HerMak56/DetaliMashine/Курсавая дед маш.docx

Московский государственный технический университет имени Н. Э. Баумана

Факультет «Робототехника и комплексная автоматизация»

Кафедра «Основы конструирования машин»

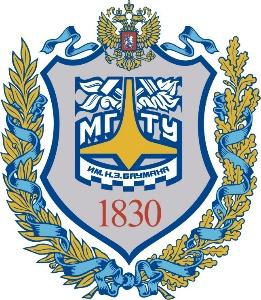
[picture p1: figure]
Gerb-BMSTU_01

МАЛ.2А213

Расчетно-пояснительная записка

к курсовому проекту

на тему:

«Привод цепного транспортёра МАЛ.2А213»

Студент РК9-63Б Девчич Г.А.

Руководитель проекта: Любченко М.А.

Дата___________________

Москва, 2023г.

Утверждаю __________

ФИО Любченко М.А.

Оглавление

1) Техническое задание
2) Обоснование выбора кинематической схемы
3) Расчет кинематических параметров
4) Результаты расчета ЭВМ
5) Расчет подшипников тихоходного вала
6) Расчет тихоходного вала на прочность и выносливость
7) Расчет соединений тихоходного вала
8) Выбор муфты
9) Список литературы

# ТЗ Обоснование выбора кинематической схемы

Целевой показатель – максимальный КПД. Для минимального передаточного отношения возьмём электродвигатель с частотой 750 об/мин. Для минимальных потерь на КПД возьмем цилиндрический редуктор по развернутой схеме.

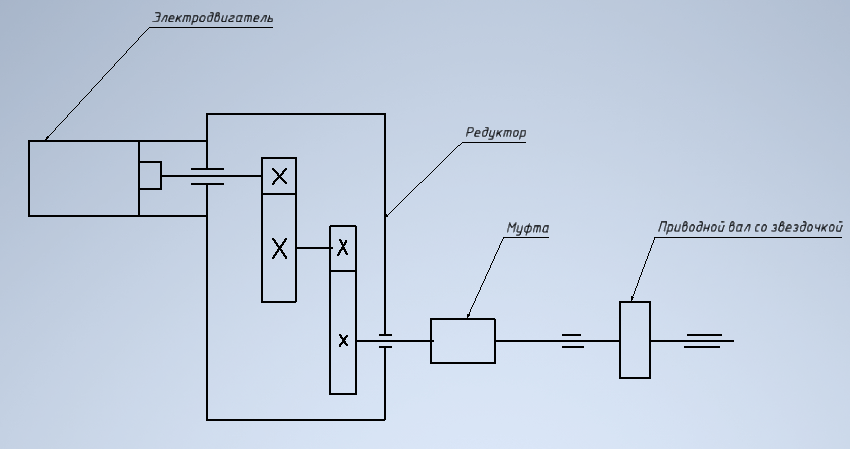
[picture p2: figure]

# Кинематический расчет привода

Для проектирования цепного транспортера, прежде всего, необходимо выбрать электродвигатель. Для этого определим мощность, потребляемую движущим устройством (цепным транспортёром), оценим КПД привода, подсчитаем вращающие моменты на валах привода. Таким образом, определим исходные данные для расчета передач.

Потребляемая мощность привода:

P_к =(F_t *v)/1000=(4.2*10^3 *0.315)/1000=1.323 кВт

Частота вращения приводного вала:

D=P/(sin((180°)/Z))=80/(sin((180°)/6))=160 мм

n_в =(6*10^4 *υ)/(π∙D)=(6*10^4 *0.315)/(3,14*160)=37.6 мин^(-1)

Тогда частота вращения тихоходного вала редуктора:

n_(тих) =n_в =37.6 (об)/(мин)

Общий коэффициент полезного действия:

η_(общ) =η_(оп) *η_(ред) *η_м =0.99*0.97^2 *0.98=0.91

Требуемая мощность электродвигателя:

P_(эл) =(P_к)/(η_(общ))=1.323/(0,91)=1.45 кВт

По таблице выбираем подходящий электродвигатель 100L7/702.

Определив двигатель и частоту вращения его шпинделя, уточним передаточное отношение редуктора.

U_(ред) =(n_б)/(n_(тих))= (n_(дв))/(n_в)= 702/37.6=18.7

Далее, определим момент на тихоходном валу.

Т_т =(P_т *9550)/(n_(тих))

Для вычисления момента, необходима мощность на тихоходном валу:

P_т =P_к =1.323 кВт

Таким образом момент на тихоходном валу:

Т_т =(P_т *9550)/(n_(тих))= (1.323*9550)/37.6=336.1 Н*м

# Компоновочная схема

Крутящий момент в поперечных сечениях валов:

1) Быстроходного: Tб= 18.1 H•м

2) Промежуточного: T_(пр) =164.1 H•м

3) Тихоходного: Tт= 336.1 H•м

Предварительные значения диаметров различных участков стальных валов редуктора округляются в ближайшую сторону до стандартных, диаметры концов валов согласуются с ГОСТ 12080-66 (цилиндрические концевые участки валов), высота заплечика, координата и размер фаски подшипника принимается согласно нормативам.

## Диаметры валов

Для быстроходного вала:

d≥7.5*³√(Т_б)=7.5*³√18.1=19.7 мм

Округляем согласно ГОСТ 6636-69 d=20 мм

d_П ≥d+2*t_(цил) =20+2*3=26 мм

Так как данный диаметр будет диаметром для подшипника кратен 5 =>

d_П =30 мм

d_(БП) ≥d_П +3*r=30+3*1.5=34.5 мм

Округлим до 35 мм

Для промежуточного вала:

d_К ≥6.5*³√(Т_(ПР))=6.5*³√82.01=28.24 мм

Округляем согласно ГОСТ 6636-69 d_К =30 мм

d_(БК) ≥d_К +3*f=30+3*1=33 мм

d_П =d_К -3*r=30-3*2=24 мм ≈25 мм

d_(БП) ≥d_П +3*r=25+3*2=31 мм

Для тихоходного вала:

d≥5.5*³√(Т_Т)=5.5*³√336.1=38.4 мм

Округляем согласно ГОСТ 6636-69 d=40 мм

d_П ≥d+2*t_(цил) =40+2*3.5=47 мм

Так как данный диаметр будет диаметром для подшипника кратен 5 =>

d_П =50

d_(БП) ≥d_П +3*r=50+3*2.5=57.5 мм

## Эскизная компоновка редуктора

Чтобы поверхности вращающихся колес не задевали за внутренние поверхности стенок корпуса, между ними оставляем зазор:

a≈³√L+3=10 мм

Расстояние между дном корпуса и поверхность колес:

b_0 ≥3∙a=3∙10=30мм

Расстояние между торцевыми поверхностями колес:

c=(0,3…0,5)∙a=0,5∙10=5мм

Толщина стенки редуктора:

δ=1,3⁴√(T_T)=1,3⁴√336.1=5.56≅6мм

Диаметр винтов крепления крышки:

d_(кр) =1,3³√(T_T)=1,3³√336.1=9.036≅М10

Диаметр винтов крепления корпуса к раме:

d_к =1,5∙d_(кр) =1,5∙10=15≅М16

# Результаты расчета ЭВМ

МЕХАНИЗМЫ ПЕРЕДАТОЧНЫЕ РАСЧЕТ ПРОЕКТНЫЙ ПРОГРАММА N 44

Зубчатые цилиндрические двухступенчатые

По развернутой схеме косозубые

══════════════════════════ ИСХОДНЫЕ ДАННЫЕ ══════════════════════════════════

Вращающий момент на тихоходном валу, Н.м . . 336.1

Частота вращения тихоходного вала, об/мин . . 37.6

Ресурс, час . . . . . . . . . . . . . . 10000.

Режим нагружения . . . . . . . . . . . . . . 1.

Передаточное отношение редуктора . . . . . . 18.70

Коэффициент ширины венца . . . . . . . . . . .315

Степень точности . . . . . . . . . . . . . . 8.

Коэффициент запаса по изгибной прочности . . . 2.20

Твердость поверхности зубьев Шестерни, HRCэ . .0 ВАРЬИРУЕТСЯ

Колеса, HRCэ . .0 ВАРЬИРУЕТСЯ

Минимальное допустимое число зубьев Шестерни . 12.

Отношение передаточных чисел ступеней . . . . .00 ВАРЬИРУЕТСЯ

Угол наклона зубьев, град . . . . . . . . . . .000

ПРОГРАММА N 44 ИМЯ ФАЙЛА ДАННЫХ:32111

МЕХАНИЗМЫ ПЕРЕДАТОЧНЫЕ РАСЧЕТ ПРОЕКТНЫЙ

Зубчатые цилиндрические двухступенчатые

По развернутой схеме косозубые

ПАРАМЕТРЫ ДЛЯ ВЫБОРА ВАРИАНТА

══╤═══════════╤═════╤═════╤═══════╤════════╤═══════════════════╤═══════════════

В│ Твердости,│Коэф.│Отнош│Суммарн│Диаметр │ Диаметры вершин │ Массы

а│ HRCэ │ширин│перед│межосев│впадин │ Колес, мм │ кг

р├─────┬─────┤венца│чисел│расст.,│Б-Шестер├─────────┬─────────┼────────┬──────

│Шест.│Колес│ │ступе│ мм │ни, мм │Т-ступень│Б-ступень│механ. │колес

──┴─────┴─────┴─────┴─────┴───────┴────────┴─────────┴─────────┴────────┴──────

1 28.5 24.8 .315 .70 240.00 35.91 255.35 143.34 49. 12.8

2 28.5 24.8 .315 1.00 245.00 31.21 247.24 158.04 49. 13.0

3 28.5 24.8 .315 1.30 255.00 31.25 241.16 178.00 51. 13.7

4 49.0 28.5 .315 .70 200.00 28.39 213.35 120.86 38. 7.5

5 49.0 28.5 .315 1.00 200.00 25.20 199.04 134.05 37. 7.0

6 49.0 28.5 .315 1.30 210.00 26.76 193.15 152.49 38. 7.5

7 59.0 59.0 .315 .70 168.00 22.20 174.82 102.80 31. 4.4

8 59.0 59.0 .315 1.00 163.00 22.20 168.72 102.80 29. 4.0

9 Bариант отброшен по конструктивным ограничениям:

мало расстояние между колесом быстроходной ступени и тихоходным валом

**

МЕХАНИЗМЫ ПЕРЕДАТОЧНЫЕ РАСЧЕТ ПРОЕКТНЫЙ

Зубчатые цилиндрические двухступенчатые

По развернутой схеме косозубые Вариант 8

═══════════════════════════ РЕЗУЛЬТАТЫ РАСЧЕТА ══════════════════════════════

Характеристика механизма

Передаточное отношение механизма . . . . . . . . . . . . . 18.545

Вращающий момент на Быстроходном валу, Н.м . . . . . . . . 18.7

Тихоходном валу, Н.м . . . . . . . . 336.1

Частота вращения Быстроходного вала, об/мин . . . . . . . . 697.3

Тихоходного вала, об/мин . . . . . . . . 37.6

Масса Механизма, кг . . . . . . . . . . . . . . . . . . . 29.3

Колес, кг . . . . . . . . . . . . . . . . . . . 4.03

Степень точности . . . . . . . . . . . . . . . . . . . 8.

───────────────────────────────────────────────┬───────────────┬──────────────

Ступень │ Тихоходная │ Быстроходная

───────────────────────────────────────────────┴───────────────┴──────────────

Передаточное число . . . . . . . . . . 4.636 4.000

Коэффициент ширины венца . . . . . . . . . . .315 .315

Межосевое расстояние, мм . . . . . . . . . . 100.000 63.000

Угол зацепления, град . . . . . . . . . . 21.374 20.915

Угол наклона зубьев, град . . . . . . . . . . 21.565 17.753

Модуль зацепления (нормальный), мм . . . . . 3.000 2.000

Силы в зацеплении, Н:

Окружная (суммарная для шеврона) . . . . 4085.9 1467.7

Радиальная (суммарная для шеврона) . . . . 1599.1 560.9

Осевая . . . . 1614.9 469.9

Вращающий момент на Шестерне, Н.м . . . . 74.0 18.7

Контактные напряжения, МПа:

при номинальной нагрузке:

расчетные . . . . . . . . . . . . . 976.9 899.2

допускаемые . . . . . . . . . . . . . 1278.6 1074.3

при максимальной нагрузке:

расчетные . . . . . . . . . . . . . 1449.0 1333.8

допускаемые . . . . . . . . . . . . . 2596.0 2596.0

──────────────────────────────────────┬───────────────────┬──────────────────

Ступень │ Тихоходная │ Быстроходная

──────────────────────────────────────┼─────────┬─────────┼─────────┬────────

Параметры зубчатого Колеса │ Шестерня│ Колесо │ Шестерня│ Колесо

──────────────────────────────────────┴─────────┴─────────┴─────────┴────────

Число зубьев . . . . . . . . 11. 51. 12. 48.

Коэффициент смещения исходного контура .300 -.300 .500 -.500

Диаметры, мм:

Делительный . . . . . . . . 35.484 164.516 25.200 100.800

Начальный . . . . . . . . 35.484 164.516 25.200 100.800

Вершин . . . . . . . . 43.284 168.716 31.200 102.800

Впадин . . . . . . . . 29.784 155.216 22.200 93.800

Ширина зубчатого венца, мм . . . . 35.0 32.0 22.0 20.0

Твердость поверхности зубьев, HRCэ . . 59.0 59.0 59.0 59.0

Напряжения изгиба, МПа:

при номинальной нагрузке:

расчетные . . . . . . . . 180.1 192.0 148.7 184.2

допускаемые . . . . . . . . 323.1 318.2 333.4 330.3

при максимальной нагрузке:

расчетные . . . . . . . . 396.3 422.4 327.2 405.3

допускаемые . . . . . . . . 1194.6 1176.5 1196.4 1185.6

ПРОГРАММА N 44 ИМЯ ФАЙЛА ДАННЫХ:32111

**

# Расчет соединений

## Расчет шпонки быстроходного вала

Рабочая длина шпонки lраб назначается таким образом, чтобы нагрузочная способность соединения ограничивалась напряжениями смятия σсм на боковых гранях шпонки. В расчете условно полагаем распределение σсм равномерным.

σ_(см) =(2∙T∙10^3)/(d∙(h-t)∙l_(раб))≤[σ_(см) ]

[σ_(см) ] – допускаемое напряжение для материала шпонки;

T – момент на валу.

d – диаметр вала.

h – высота шпонки, t – глубина врезания шпонки.

b – ширина шпонки.

Тогда полная длина шпонки:

L=l_(раб) +b

Шпонки изготовляются из чисто-тянутой стали 45 σ_Т =360МПа. Поэтому допускаемое напряжение:

[σ_(см) ]=(σ_Т)/S=(360МПа)/2=180Мпа

Найдем потребную рабочую длину шпонки:

l_(раб) =(2∙T∙10^3)/(d∙(h-t)∙[σ_(см) ])

Для быстроходного вала:

d=28 мм.

TБ=18.1 Н ∙ м.

Параметры выбранной шпонки по ГОСТ 23360-78:

b= 8 мм.

h=7 мм.

t1=4 мм.

l_(раб) =(2∙18.1∙10^3)/(28∙(7-4)∙180)=2.39мм

Тогда полная длина шпонки:

L=2.5+8=10.5мм

Значит изначальной длинны шпонки в 56 мм будет достаточно

## Расчет шпонки тихоходного вала

σ_(см) =(2∙T∙10^3)/(d∙(h-t)∙l_(раб))≤[σ_(см) ]

[σ_(см) ] – допускаемое напряжение для материала шпонки;

T – момент на валу.

d – диаметр вала.

h – высота шпонки, t – глубина врезания шпонки.

b – ширина шпонки.

Тогда полная длина шпонки:

L=l_(раб) +b

Шпонки изготовляются из чисто-тянутой стали 45 σ_Т =360МПа. Поэтому допускаемое напряжение:

[σ_(см) ]=(σ_Т)/S=(360МПа)/2=180Мпа

Найдем потребную рабочую длину шпонки:

l_(раб) =(2∙T∙10^3)/(d∙(h-t)∙[σ_(см) ])

Для быстроходного вала:

d=50 мм.

TБ=336.1 Н ∙ м.

Параметры выбранной шпонки по ГОСТ 23360-78:

b=16 мм.

h=10 мм.

t1=6мм.

l_(раб) =(2∙336.1∙10^3)/(50∙(10-6)∙180)=18.6мм

Тогда полная длина шпонки:

L=18.6+16=34.6мм

Минимальная длина, заданная ГОСТом L=45 мм

## Расчет соединения с натягом для тихоходного вала

СОЕДИНЕНИЯ РАСЧЕТ ПРОЕКТНЫЙ

с Натягом

═══════════════════════════ ИСХОДНЫЕ ДАННЫЕ ═════════════════════════════

Способ сборки . . . . . . ЗАПРЕССОВКА

Осевая сила, Н . . . . . . . .0

Вращающий момент, Н.м . . . . . . . 345.0

Коэффициент запаса сцепления . . . . 3.5

Номинальный диаметр соединения, мм . . 65.0

Длина контакта, мм . . . . . . . 70.0

Диаметр отверстия в вале, мм . . . . . .0

Наружный диаметр втулки, мм . . . . . 181.5

Параметры: Вала Втулки

Параметр шероховатости Ra, мкм . . . . 3.3 6.3

Рабочая температура, °C . . . . . . 40.0 40.0

Модуль упругости, МПа . . . . . . 190000. 190000.

Коэффициент Пуассона . . . . . . .24 .33

Kоэффициент линейного расширения, 1/ °C .000012 .000012

Предел текучести, МПа . . . . . . 330. 330.

Коэффициент трения при расчете . . . . .08

Коэффициент трения при запрессовке . . . .20

СОЕДИНЕНИЯ РАСЧЕТ ПРОЕКТНЫЙ

с Натягом

Сборка запрессовкой

ПАРАМЕТРЫ ДЛЯ ВЫБОРА ВАРИАНТА

══╤═════════╤════════════════════════╤═════════════════════════╤═════════

│ │ Отклонения, мкм │ Вероятностный натяг, мкм│ Сила

В│ Посадка ├─────────┬──────┬───────┼────────────┬────────────┤ запрес-

а│ │ Верхнее │Нижнее│Верхнее│ мини- │ макси- │совки, кН

р│ │отверстия│ вала │ вала │ мальный │ мальный │

──┴─────────┴─────────┴──────┴───────┴────────────┴────────────┴─────────

1 H7/v7 30. 102. 132. 81. 123. 247.1

2 H8/x8 46. 122. 168. 89. 155. 356.8

3 H7/x7 30. 122. 152. 101. 143. 317.1

4 H7/y7 30. 144. 174. 123. 165. 394.2

**

# Расчет подшипников на долговечность

## Расчёт подшипников тихоходного вала

Исходные данные:

Частота вращения вала n=37.6 об/мин

Вероятность безотказной работы 90%

Требуемый ресурс L10ah=10000 часов

Радиальная сила в зацеплении тихоходной ступени Fr1= 1599.1Н

Окружная сила в зацеплении тихоходной ступени Ft1= 4085.9Н

Осевая сила в зацеплении тихоходного вала F_a =1614.9 Н

Режим нагружения I

Консольная нагрузка Fк= 250*√(T_T) =4583.2 Н

l=112.25 мм

l1=36 мм

l2=67.75 мм

d = 164.5 мм

Расчётная схема:

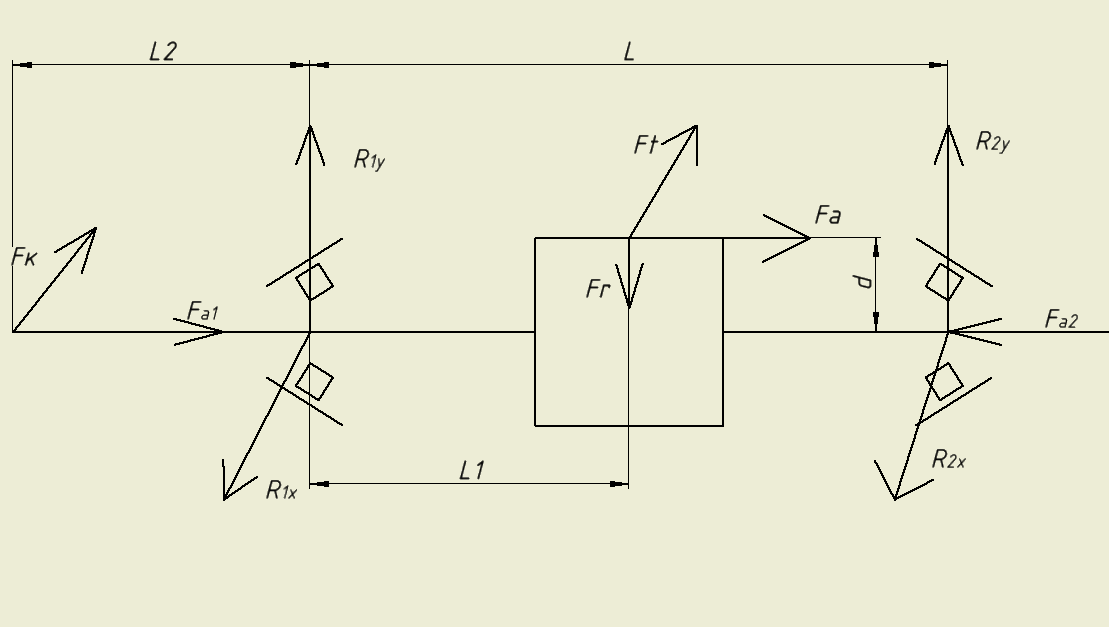
[picture p3: figure]

Определение радиальных реакций опор от сил в зацеплении.

Считая, что в худшем случаем консольная сила совпадет с суммарными реакциями опор:

В плоскости YOZ

∑ M_1 =F_r *l1+F_a *d/2-R_(2y) *l=0;

R_(2y) =1696.15Н

По сумме силы вдоль оси Oy найдем недостающую реакцию.

∑ F_y =R_(1y) -F_r +R_(2y) =0

R_(1y) =-97.05Н

В плоскости XOZ

∑ M_1 =-F_t *l1+R_(2x) *l=0

R_(2x) =1310.4Н

По сумме силы вдоль оси Oy найдем недостающую реакцию.

∑ F_x =R_(1x) +R_(2x) -F_t =0

R_(1x) =2775.5Н

R_1 =√(R_(1x) ^2 +R_(1y) ^2)=2777.2Н

R_2 =√(R_(2x) ^2 +R_(2y) ^2)=2143.13Н

∑ M_1 =F_к ∙l_2 -R_(2к) ∙l=0;

R_(2к) =2766.2 Н

∑ M_2 = F_к ∙(l_2 +l)-R_(1к) l=0;

R_(1к) =7757.7 Н

Для 1 режима нагружения, коэффициент эквивалентности 0,8. Эквивалентные нагрузки: F_(r1max) =R_1 +R_(1к) =10534.9 Н , F_(r2max) =R_2 +R_(2к) =5532. Н , F_(r2) =K_E ∙F_(r2max) =8427.2 Н F_(r1) =K_E ∙F_(r1max) =4425.6 Н

Поскольку в данной системе присутствует осевая сила, и подшипники являются регулируемыми, то запишем уравнение совместности:

{, F_(a1) +F_a -F_(a2) =0, F_(a1) ≥0.83e*R_1 =1469.2 H, F_(a2) ≥0.83e*R_2 =2797.8 H

Пусть F_(a1) =1469.2 , подствами в систему уравнений выше, получим что F_(a2) =3084.1>656,65

Таким образом, мы подобрали осевые регулировки у подшипников.

(F_(a1))/(R_1)=0.34<e

что не превышает полученного значения параметра осевого нагружения, а значит, и . Следовательно, эквивалентная динамическая нагрузка в опоре 1 составляет:

P_(r1) =(1*4426.6+0)*1,5=6638.4 H

(F_(a2))/(R_2)=1,24>e

P_(r2) =(1,4*5532+0.8*2537)*1,5=14661.6 H

Так как подшипник у опоры 2 является наиболее нагруженным, ведем расчет по нему.

P_(r2) =P_r = 14661.6 H

Для проведения дальнейших расчетов проверим соблюдение условия . Эта проверка выполняется без учета коэффициента типового режима нагружения:

P_(re) =P_r *k_e =0.8*14661.6=11729.2 H

Здесь – коэффициент, учитывающий номер типового режима нагружения, значение которого выбрано в соответствии с Таблицей П3.8 Приложения П3 для типового режима нагружения 1.

Определим системный коэффициент модификации ресурса по формуле:

Коэффициент относительной вязкости смазочного материала зависит от вязкости смазочного материала и вычисляется по формуле:

где – действительная кинематическая вязкость смазочного материала с учетом температуры, для масла И-Г-А-46 равная [6]:

Номинальная кинематическая вязкость масла для подшипника 7210А равного:

Тогда номинальная кинематическая вязкость составляет:

Следовательно:

Коэффициент
Значение | 2,5859 | 1,3993 | 0,054381 | 0,4 | 1,0 | 1 | 9,185

Тогда системный коэффициент модификации ресурса будет равен:

Следовательно, расчетный ресурс подшипника 7206А в часах для наиболее нагруженной опоры равен:

Отношение эквивалентной динамической нагрузки к динамической грузоподъемности:

(P_r)/(C_r)=8876.52/70400=0,107 , следовательно, принимаем поле допуска вала k6.

Для внешнего кольца:

(P_r)/(C_r)=8876.52/70400=0,107 следовательно, принимаем поле допуска отверстия H7.

## Расчет вала на прочность

Для выполнения расчета, необходимо определить опасное сечение. Для его определения, построим эпюры от нагружающих сил. Реакции в подшипниках мы определили в пункте расчета подшипников. Как видно из эпюр, наиболее опасное сечение, является там, где находится тихоходная шестерня.

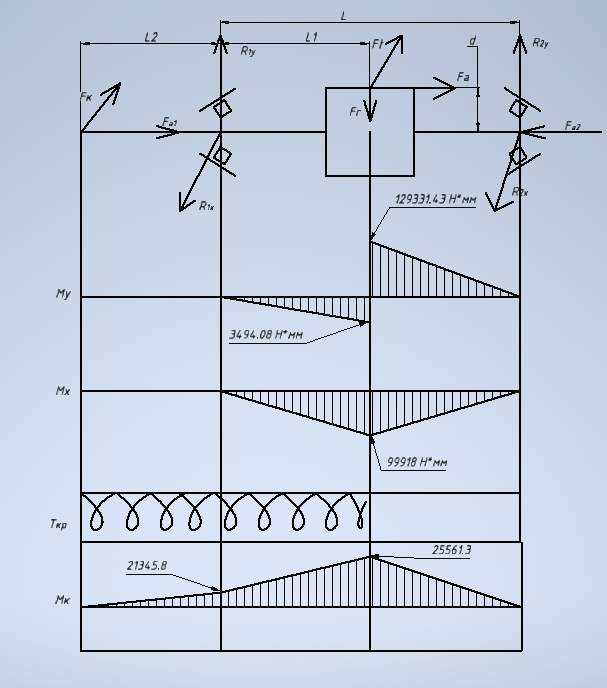
[picture p4: figure]

М_(кр) = T= 10^(-3) *F_t *d/2=10^(-3) *4085.9*164.5/2=336.1 Н*м

М_y =129.33 Н*м

М_х =99.918 Н*м

М_к =25.561 Н*м

F_a =1614.9 Н

Суммарный изгибающий момент равен: М=√(М_y ^2 +М_х ^2)+М_к = √(129.33^2 +99.918^2)+25.561=188.9 Н*м

Вычисление геометрических характеристик:

W= π*(d^3)/32= π*(60^3)/32=21205.7 мм^3

W_к = π*(d^3)/16= π*(60^3)/16=42411.5 мм^3

A= π*(d^2)/4= π*(60^2)/4=2827.4 мм^3

## Расчет вала на статическую прочность

σ=10^3 *К_п *М/W+К_п *(F_a)/A=10^3 *2.2*188.9/21205.7+2.2*1614.9/2827.4= 20.85 Мпа

τ=10^3 *К_п *(М_(кр))/(W_к)=10^3 *2.2*336.1/42411.5=17.43 МПа

S_(тσ) =(σ_т)/σ = 640/20.85=30.7

S_(тτ) =(τ_т)/τ = 290/17.43=16.65

S_т = S_(тσ) *(S_(тτ))/(√(S_(тσ) ^2 +S_(тτ) ^2))=30.7*16.65/(√(30.7^2 +16.65^2))=14.63

Так как, данное сечение является наиболее нагруженным, и данном сечении выполнятся равенство S≥[S_т ]=2 , то во всех сечения статическая прочность обеспечена.

## Расчет вала на сопротивление усталости

σ_а =σ_и =10^3 *К_п *М/W= 10^3 *2.2*188.9/21205.7=19.6 МПа

τ_a =(τ_k)/2=10^3 *К_п *(М_к)/(2*W_к)=10^3 *2.2*336.1/(2*42411.5)=8.17 МПа

Согласно таблице 10.12 (K_σ)/(Kd_σ)=4.7 (K_τ)/(Kd_τ)= 2.8

Согласно таблице 10.8 K_(Fσ) =0.85 K_(Fτ) =0.9

Согласно таблице 10.9 K_V =1

K_(σD) =((K_σ)/(Kd_σ)+1/(K_(Fσ))-1)/(K_V)=(4.7+1/0.85-1)/1=4.87

K_(τD) =((K_τ)/(Kd_τ)+1/(K_(Fτ))-1)/(K_V)=(2.8+1/0.9-1)/1=2.91

σ_(-1D) = σ_(-1) 1/(K_(σD))=410/4.87=84.2 МПа

τ_(-1D) = τ_(-1) 1/(K_(τD))=230/2.91=79.03 МПа

ψ_(τD) =ψ_τ 1/(K_(τD))=0.1/2.91=0.034

S_σ =(σ_(-1D))/(σ_а) =84.2/19.6=4.29

S_τ =(τ_(-1D))/((τ_a +τ_a *ψ_(τD) ))= 79.03/((8.17+0.034*8.17))=9.35

S= S_σ *(S_τ)/(√(S_σ ^2 +S_τ ^2))=(4.29*9.35)/(√(4.29^2 +9.35^2))=3.89

Так как, данное сечение является наиболее нагруженным, и данном сечении выполнятся равенство S≥[S]=2 , то во всех сечения сопротивление усталости вала обеспечено.

# Расчёт комбинированной муфты.

## Расчет момента срабатывания муфты.

Комбинированная муфта выбрана для того, чтобы в связи с неизбежными перекосами и смещениями редуктора относительно приводного вала, а также в связи с прогибами тихоходного вала во время работы, обеспечить точное соосное положение валов редуктора и приводного вала. Используем упруго-компенсирующую муфту со стальными стержнями.

Так как приводной вал имеет звездочки, то в случае аварийной перегрузки необходимо обеспечить разрыв кинематической цепи, для чего используется предохранительная муфта.

Электродвигатель АИР100L8/702, Pэд = 1.5 кВ, n = 750 об/мин.

Передаточное число от электродвигателя до приводного вала U = 18,5 tf = 0.98

T_(эд) =9550(P*10^3)/n=95501500/750=19,1 Нм

Т_(сраб) =T_(эд) *U*tf*((Т_(пуск))/(Т_(номин))+(Т_(max))/(Т_(номин)))/2 >1.2*T_(эд) *(Т_(пуск))/(Т_(номин))*U*tf

Согласно технической документации на двигатель, (Т_(пуск))/(Т_(номин))=3.7 , (Т_(max))/(Т_(номин))=2

Т_(сраб) =19.1*0.98*18.5*(2+3.7)/2=986,9>1.2*19.1*3.7*18.5*0.98=1537.5 Нм

Муфту рассчитываем на срабатывание при моменте Т_(сраб) =1537.5 Нм

## Определение диаметра штифта.

Для надежности констукции, назначим число штифтов z = 1, тогда k = 1. Штифты гладкие: c =0.75. Материал штифтов – сталь 40Х, закаленная до HRC = 45..50. σ_(вр) =900 МПа, τ_(срез) =675 Мпа

Пусть, R = 42.5, тогда dш ≥ √((T_(ср) *10^3 *4*1)/(π*τ_(срез) *R*1))=6.3 мм, примем диаметр штифтов 6 мм., тогда R= (T_(ср) *10^3 *4*1)/(π*τ_(срез) *1)=47.3 мм

Список литературы

1. Конструирование узлов и деталей машин: учеб. пособие для студ. высш. учеб. заведений / П. Ф. Дунаев, О. П. Леликов. – 11-е изд., стер. – М.: Издательский центр «Академия», 2008. – 496 с.

2. Методические указания к выполнению домашнего задания по разделу «Соединения» курса «Основы конструирования деталей и узлов машин» / Л.П. Варламова, В.П. Тибанов; Под ред. Л.П. Варламовой. – М.: Изд-во МГТУ им. Н.Э. Баумана, 1997. – 80 с., ил.

3. Атлас конструкций узлов и деталей машин. Под ред. О. А. Ряховского. – М.: Изд-во МГТУ им. Н.Э. Баумана, 2005. – 376 с., ил.
