HerMak56/DetaliMashine/Новая папка/Чертежи/Спецификаця_Лист1.pdf

Изм. Лист | | № докум. | Подп. | Дата
| | Разраб. | Девчич Г.А. | | Лит. | Лист | Листов
Пров. | Любченко М.А. | | | | | | 1

Н.контр.
Утв.
Редуктор двухступенчатый МГТУ им. Н.Э. Баумана Инв. № подл. Подп. и дата Взам. инв. № Инв. № дубл. Подп. и дата | группа РК9-63Б Справ. № Перв. примен. | Формат Зона | Поз. | Обозначение | Наименование | Кол. | Приме-
чание

Документация

МАЛ.2А213.10.00 СБ | Сборочный чертеж | 1
МАЛ.2А213.10.00 ПЗ | Пояснительная записка | 1

Детали

1 | МАЛ.2А.213.10.11 | Вал промежуточный | 1
2 | МАЛ.2А.213.10.12 | Валл тихоходный | 1
3 | МАЛ.2А.213.10.13 | Вал-шестерня быстроходный | 1
4 | МАЛ.2А.213.10.14 | Колесо зубчатое быстроходное | 1
5 | МАЛ.2А.213.10.15 | Колесо зубчатое тихоходное | 1
6 | МАЛ.2А.213.10.16 | Колесо смазывающее малое | 1
7 | МАЛ.2А.213.10.17 | Колесо смазывающее тихоходное | 1
8 | МАЛ.2А.213.10.18 | Корпус | 1
9 | МАЛ.2А.213.10.19 | Крышка подшипника | 1
| | промежуточная закрытая
10 | МАЛ.2А.213.10.20 | Крышка подшипника | 1
| | промежуточная открытая
11 | МАЛ.2А.213.10.21 | Крышка подшипника | 1
| | тихоходная выходная
12 | МАЛ.2А.213.10.22 | Крышка подшипника | 1
| | тихоходная открытая
13 | МАЛ.2А.213.10.23 | Маслоуказатель | 1
14 | МАЛ.2А213.10.24 | Маслянная пробка | 1
15 | МАЛ.2А213.10.24 | Маслянная пробка с отдушиной | 1
16 | МАЛ.2А.213.10.25 | Регулировочная крышка промежуточная | 1
17 МАЛ.2А.213.10.26 | | Регулировочная крышка тихоходная | 1
| | | МАЛ.2А213.10.00
Копировал | Формат A4
