HerMak56/DetaliMashine/Новая папка/Чертежи/Спецификаця_Лист1_ВО.pdf

Изм. Лист | № докум. | Подп. | Дата
Разраб. | Лист | Листов
Пров.

Лит.

Н.контр.
Утв.

1

## МАЛ.2А213.00.00 ВО Привод цепного

транспортера МГТУ им. Н.Э. Баумана группа РК9-63Б

Девчич Г.А.

Любченко М.А. Инв. № подл. Подп. и дата Взам. инв. № Инв. № дубл. Подп. и дата Справ. № Перв. примен. | Формат Зона | Поз. | Обозначение | Наименование | Кол. | Приме-
чание
1 | МАЛ.2А213.10.00 СБ | Мотор-редуктор | 1
2 | МАЛ.2А213.30.00 СБ | Муфта комбинированная | 1
3 | МАЛ.2А213.20.00 СБ | Приводной вал | 1
4 | МАЛ.2А213.40.00 СБ | Рама | 1
МАЛ.2А213.00.00 ВО | Чертеж общего вида
МАЛ.2А213.00.00 ПЗ | Пояснительная записка

Документация

Сборочные единицы

| Стандартные изделия
5 | Болт M16-6g ГОСТ 7798-70 | 4
6 | Болт 6.1. М16 х 350 | 8
| ГОСТ 24379.1-2012
7 | Болт M12-6g ГОСТ 7798-70 | 4
8 | Гайка M16-6H ГОСТ 5915-70 | 4
9 | Гайка M12-6H ГОСТ 5915-70 | 4
10 | Шайба 16 ГОСТ 11371-78 | 4
Копировал | Формат A4
