HerMak56/DetaliMashine/Новая папка/Чертежи/Спецификаця_Лист2.pdf

Изм. Лист | № докум. | Подп. | Дата Инв. № подл. Подп. и дата Взам. инв. № Инв. № дубл. Подп. и дата | МАЛ.2А213.10.00 Формат Зона | Поз. | Обозначение | Наименование | Кол. | Приме-
| | | | чание
18 | МАЛ.2А.213.10.28 | Фланец корупса | 1
19 | МАЛ.2А.213.10.27 | Фиксатор муфты | 1
| Стандартные изделия
| Подшипники:
20 | Роликовые конические | 2
| 7205А ГОСТ 26365-87
21 | Роликовые конические | 2
| 7210А ГОСТ 26365-87
| Крепежные изделия:
22 | Болт М6-6g x 16.56.05 | 1
| ГОСТ 7798-70
23 | Винт М10-6g x 20 | 1
| ГОСТ 1491-80
24 | Винт М10-6g x 25 | 1
| ГОСТ 1491-80
25 | Винт М6 x 12 6g | 1
| ГОСТ 11074-90
26 | Гайка М10 х 1-6Н | 2
| ГОСТ 5915-70
27 | Гайка М16-6Н | 6
| ГОСТ 5915-70
28 | Кольцо 20 ГОСТ 13942-86 | 1
29 | Кольцо 60 ГОСТ 13942-86 | 2
30 | Манжета 1-30x47x7 ГОСТ 8752-79 | 1
31 | Манжета 2-55x72x8 ГОСТ 8752-79 | 1
32 | Прокладка ГОСТ 15180-86 | 1
33 | Шайба 12 ГОСТ 6402-70 | 1
34 | Шайба 16 ГОСТ 6402-70 | 6
35 | Шайба 7019-0631 ГОСТ 14734-69 | 1
| | | Лист
Копировал | Формат A4
