HerMak56/DetaliMashine/Новая папка/Чертежи/Спецификаця_Лист3.pdf

Лист

Изм. Лист | № докум. | Подп. | Дата Инв. № подл. Подп. и дата Взам. инв. № Инв. № дубл. Подп. и дата | МАЛ.2А213.10.00 Формат Зона | Поз. | Обозначение | Наименование | Кол. | Приме-
| | | чание
36 | Шпилька М16-6g x 120.58 | 6
| ГОСТ 22034-76
37 | Шпонка 8x7x26 ГОСТ 23360-78 | 1
38 | Шпонка 16x10x45 ГОСТ 23360-78 | 1
39 | Штифт 4x5 ГОСТ 3128-70 | 1
40 | Электродвигатель АИР100L2 | 1

Материалы
Масло И-Г-А 32 | 1.4 л
ГОСТ 20799-88
Герметик Loctite 518 | 50 мл
Копировал | Формат A4
