HerMak56/DetaliMashine/Новая папка/Сборка_редуктора+муфта/Фундаментальная хуйня.stp

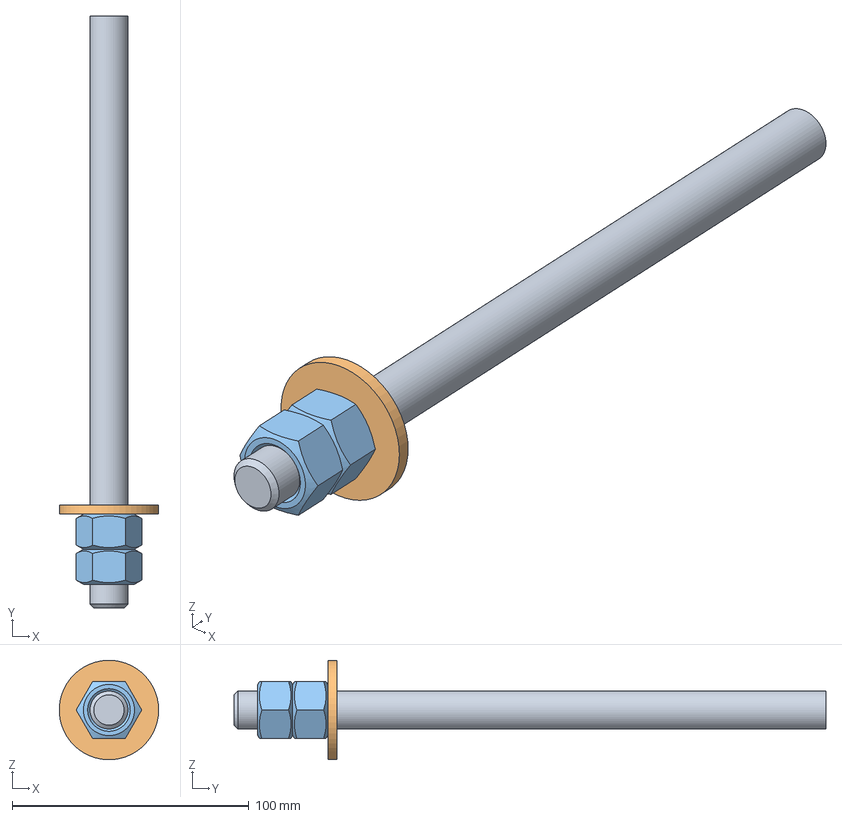
[picture p5: CAD file, 2023-05-19]
Новая папка/Сборка_редуктора+муфта/Фундаментальная хуйня.stp
42.0 x 250.0 x 42.0 mm
