HerMak56/DetaliMashine/Новая папка/Сборка_редуктора+муфта/Фундаментальная хуйня1.stp

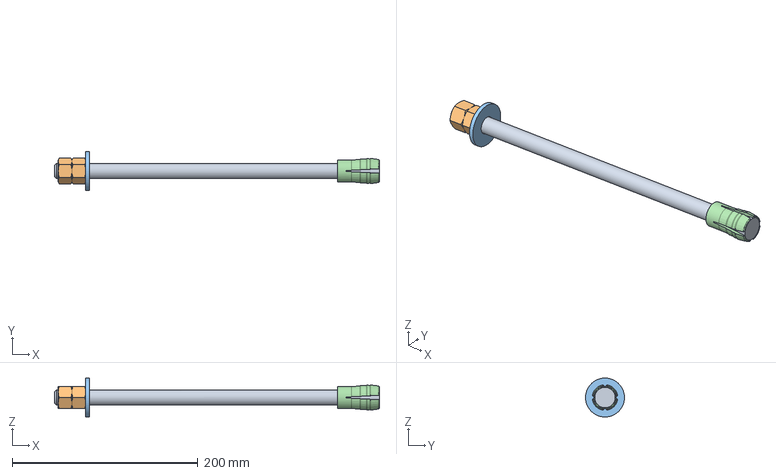
[picture p6: CAD file, 2023-05-19]
Новая папка/Сборка_редуктора+муфта/Фундаментальная хуйня1.stp
350.2 x 42.0 x 42.0 mm
