HerMak56/DetaliMashine/(list of files, cad)

Other CAD files:
Новая папка/Чертежи/Лист_Муфт.dwg
Новая папка/Чертежи/Тихое_колесо.dwg
Новая папка/Чертежи/Тихоходный валл.dwg
Новая папка/Чертежи/Чертеж для подшипника.dwg
Новая папка/Чертежи/Тихоходное колесо1.dwg
Новая папка/Чертежи/Тихоходное колесо.dwg
Новая папка/Чертежи/Тихоходное колесо2.dwg
Новая папка/Чертежи/Ghj,ystq.dwg
Новая папка/Чертежи/Сборка_Конечная.dwg
Новая папка/Чертежи/OldVersions/Лист_Муфт.0010.dwg
Новая папка/Чертежи/OldVersions/Тихое_колесо.0013.dwg
Новая папка/Чертежи/OldVersions/Тихоходный валл.0012.dwg
Новая папка/Чертежи/OldVersions/Чертеж для подшипника.0005.dwg
Новая папка/Чертежи/OldVersions/Тихоходное колесо.0001.dwg
Новая папка/Чертежи/OldVersions/Ghj,ystq.0001.dwg
Новая папка/Чертежи/OldVersions/Сборка_Конечная.0022.dwg
Новая папка/1-я створка.ipt
Новая папка/2-я створка.ipt
Новая папка/ANSI B 18.2.4.1 M - M10 x 1,5Style 1.ipt
Новая папка/Doliv_masla (1).ipt
Новая папка/OldVersions/1-я створка.0005.ipt
Новая папка/OldVersions/2-я створка.0005.ipt
Новая папка/OldVersions/Doliv_masla (1).0001.ipt
Новая папка/OldVersions/Вал_промежуточный.0010.ipt
Новая папка/OldVersions/Вал_тихоходный.0011.ipt
Новая папка/OldVersions/Вал_тихоходный.0013.ipt
Новая папка/OldVersions/Вал_тихоходный.0014.ipt
Новая папка/OldVersions/Валл быстроходный.0009.ipt
Новая папка/OldVersions/Валл быстроходный.0012.ipt
Новая папка/OldVersions/Валл_резина.0002.ipt
Новая папка/OldVersions/Втулка_Штрифта.0001.ipt
Новая папка/OldVersions/Демфер пальца.0003.ipt
Новая папка/OldVersions/Колесо быстроходное.0003.ipt
Новая папка/OldVersions/Корпус.0004.iam
Новая папка/OldVersions/Корпус.0044.ipt
Новая папка/OldVersions/Корпус.v.2.0.0022.iam
Новая папка/OldVersions/Корпус_v.0.1.0009.iam
Новая папка/OldVersions/Крышка тих.0003.ipt
Новая папка/OldVersions/Крышка тих_выход.0006.ipt
Новая папка/OldVersions/Крышка, тихая.0004.ipt
Новая папка/OldVersions/Крышка_быстроходного.0007.ipt
Новая папка/OldVersions/Крышка_пром.0006.ipt
Новая папка/OldVersions/Крышка_пром_новая.0003.ipt
Новая папка/OldVersions/Левая половинка.0002.ipt
Новая папка/OldVersions/Левая створка.0011.ipt
Новая папка/OldVersions/Левая створка.0012.ipt
Новая папка/OldVersions/Муфта в сборе.0011.iam
Новая папка/OldVersions/Муфта_Корпус.0012.ipt
Новая папка/OldVersions/Правая половинка.0002.ipt
Новая папка/OldVersions/Правая створка.0011.ipt
Новая папка/OldVersions/Правая створка.0015.ipt
Новая папка/OldVersions/Промежуточное колесо резина.0001.ipt
Новая папка/OldVersions/Регулировка-тихая.0001.ipt
Новая папка/OldVersions/Редуктор в сборе.0003.idw
Новая папка/OldVersions/Редуктор в сборе.0042.iam
Новая папка/OldVersions/Резина конец.0005.ipt
Новая папка/OldVersions/Сборка_Конечная.0001.idw
Новая папка/OldVersions/Сборка_Конечная.0016.iam
Новая папка/OldVersions/Сборка_новая.0031.iam
Новая папка/OldVersions/Скольжение.0001.ipt
Новая папка/OldVersions/Слив_масла.0002.ipt
Новая папка/OldVersions/Штрифт.0001.ipt
Новая папка/Болт M10×35 ГОСТ Р 50793-95.ipt
Новая папка/Вал_промежуточный.ipt
Новая папка/Вал_тихоходный.ipt
Новая папка/Валл быстроходный.ipt
Новая папка/Валл_резина.ipt
Новая папка/Винт A.M10-6gx18 ГОСТ 17473-80.ipt
Новая папка/Винт M10-6gx18 ГОСТ 1491-80.ipt
Новая папка/Винт M10-6gx20 ГОСТ 1491-80.ipt
Новая папка/Винт M10-6gx25 ГОСТ 1491-80.ipt
Новая папка/Втулка_Штрифта.ipt
Новая папка/Втулка_Штрифта_MIR.ipt
Новая папка/Демфер пальца.ipt
Новая папка/Колесо быстроходное.ipt
Новая папка/Копия Копия гайки M10x1-6H ГОСТ 5915-70.ipt
Новая папка/Корпус.ipt
Новая папка/Корпус.v.2.0.iam
Новая папка/Корпус_v.0.1.iam
Новая папка/Крышка тих.ipt
Новая папка/Крышка тих_выход.ipt
Новая папка/Крышка тих_новая.ipt
Новая папка/Крышка, тихая.ipt
Новая папка/Крышка_быстроходного.ipt
Новая папка/Крышка_пром.ipt
Новая папка/Крышка_пром_новая.ipt
Новая папка/Левая створка.ipt
Новая папка/Левые детали/OldVersions/Тихоходное колесо.0002.ipt
Новая папка/Левые детали/OldVersions/Тихоходный валл.0005.idw
Новая папка/Левые детали/OldVersions/Тихоходный валл.0007.ipt
Новая папка/Левые детали/Болт M10-6g×10(S16) ГОСТ 7798-70.ipt
Новая папка/Левые детали/Гайка M10-6H ГОСТ 5915-70(1).ipt
Новая папка/Левые детали/Тихоходное колесо.ipt
Новая папка/Левые детали/Тихоходный валл.idw
Новая папка/Левые детали/Тихоходный валл.ipt
Новая папка/Манжет 1-30x47x7 ГОСТ 8752-79.ipt
Новая папка/Манжет 1-32x45x7 ГОСТ 8752-79.ipt
Новая папка/Манжет 2-50x65x8 ГОСТ 8752-79.ipt
Новая папка/Манжет 2-55x72x8 ГОСТ 8752-79.ipt
Новая папка/Муфта в сборе.iam
Новая папка/Муфта_Корпус.ipt
Новая папка/Палец_ребрышко.ipt
Новая папка/Подшипник 205 ГОСТ 8338-75.ipt
Новая папка/Подшипник 210 ГОСТ 8338-75.ipt
Новая папка/Подшипник 7205A ГОСТ 27365-8v.1.ipt
Новая папка/Правая створка.ipt
Новая папка/Приводной валл/OldVersions/Валл.0009.ipt
Новая папка/Приводной валл/OldVersions/Корпус_Подшипника.0010.ipt
Новая папка/Приводной валл/OldVersions/Крышка правая.0003.ipt
Новая папка/Приводной валл/OldVersions/Крышка правая.0004.ipt
Новая папка/Приводной валл/OldVersions/Крышка_Левая.0003.ipt
Новая папка/Приводной валл/OldVersions/Сборка вала.0015.iam
Новая папка/Приводной валл/OldVersions/звездочка.0004.ipt
Новая папка/Приводной валл/Валл.ipt
Новая папка/Приводной валл/Корпус_Подшипника.ipt
Новая папка/Приводной валл/Крышка правая.ipt
Новая папка/Приводной валл/Крышка_Левая.ipt
Новая папка/Приводной валл/Манжет 2-55x72x8 ГОСТ 8752-79.ipt
Новая папка/Приводной валл/Манжет 2-60x80x8 ГОСТ 8752-79.ipt
Новая папка/Приводной валл/Подшипник 1211 ГОСТ 28428-90.ipt
Новая папка/Приводной валл/Подшипник 1212 ГОСТ 28428-90.ipt
Новая папка/Приводной валл/Сборка вала.iam
Новая папка/Приводной валл/звездочка.ipt
Новая папка/Промежуточное колесо резина.ipt
Новая папка/Проставка.ipt
Новая папка/Рама/OldVersions/Новый эскиз рамы.0005.ipt
Новая папка/Рама/OldVersions/Рама.0013.iam
Новая папка/Рама/OldVersions/Рама_сварная.0001.iam
Новая папка/Рама/OldVersions/Рама_сварная_v.2.0016.iam
Новая папка/Рама/OldVersions/Шпилька.0001.ipt
Новая папка/Рама/OldVersions/Эскиз_рамы.0005.ipt
Новая папка/Рама/Новый эскиз рамы.ipt
Новая папка/Рама/Рама.iam
Новая папка/Рама/Рама/Frame/Frame 1682588975700.iam
Новая папка/Рама/Рама/Frame/OldVersions/Frame 1682588975700.0010.iam
Новая папка/Рама/Рама/Frame/OldVersions/Skeleton 1682588975701.0003.ipt
Новая папка/Рама/Рама/Frame/OldVersions/ГОСТ 10704-91 Труба 16x1 ГОСТ 10704-91 1682589568756.0002.ipt
Новая папка/Рама/Рама/Frame/OldVersions/ГОСТ 10704-91 Труба 16x1 ГОСТ 10704-91 1682589585832.0001.ipt
Новая папка/Рама/Рама/Frame/OldVersions/ГОСТ 10704-91 Труба 16x1 ГОСТ 10704-91 1682589629382.0002.ipt
Новая папка/Рама/Рама/Frame/OldVersions/ГОСТ 10704-91 Труба 16x1 ГОСТ 10704-91 1682589644080.0002.ipt
Новая папка/Рама/Рама/Frame/OldVersions/ГОСТ 10704-91 Труба 16x1 ГОСТ 10704-91 1683550217717.0001.ipt
Новая папка/Рама/Рама/Frame/OldVersions/ГОСТ 10704-91 Труба 16x1 ГОСТ 10704-91 1683550217767.0001.ipt
Новая папка/Рама/Рама/Frame/OldVersions/ГОСТ 8240-97 Швеллер 6.5U ГОСТ 8240-97 1682588981570.0002.ipt
Новая папка/Рама/Рама/Frame/OldVersions/ГОСТ 8240-97 Швеллер 6.5U ГОСТ 8240-97 1682588997713.0001.ipt
Новая папка/Рама/Рама/Frame/OldVersions/ГОСТ 8240-97 Швеллер 6.5U ГОСТ 8240-97 1682589043592.0001.ipt
Новая папка/Рама/Рама/Frame/OldVersions/ГОСТ 8240-97 Швеллер 6.5U ГОСТ 8240-97 1682589088207.0002.ipt
Новая папка/Рама/Рама/Frame/OldVersions/ГОСТ 8240-97 Швеллер 6.5U ГОСТ 8240-97 1682589111712.0002.ipt
Новая папка/Рама/Рама/Frame/OldVersions/ГОСТ 8240-97 Швеллер 6.5U ГОСТ 8240-97 1682589133422.0002.ipt
Новая папка/Рама/Рама/Frame/OldVersions/ГОСТ 8240-97 Швеллер 6.5U ГОСТ 8240-97 1682589149750.0002.ipt
Новая папка/Рама/Рама/Frame/OldVersions/ГОСТ 8240-97 Швеллер 6.5U ГОСТ 8240-97 1682589163263.0003.ipt
Новая папка/Рама/Рама/Frame/OldVersions/ГОСТ 8240-97 Швеллер 6.5U ГОСТ 8240-97 1682589209190.0001.ipt
Новая папка/Рама/Рама/Frame/OldVersions/ГОСТ 8240-97 Швеллер 6.5U ГОСТ 8240-97 1682589232512.0002.ipt
Новая папка/Рама/Рама/Frame/OldVersions/ГОСТ 8240-97 Швеллер 6.5U ГОСТ 8240-97 1682589715783.0001.ipt
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
