HerMak56/DetaliMashine/Новая папка/Чертежи/Сборка_Конечная.pdf

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

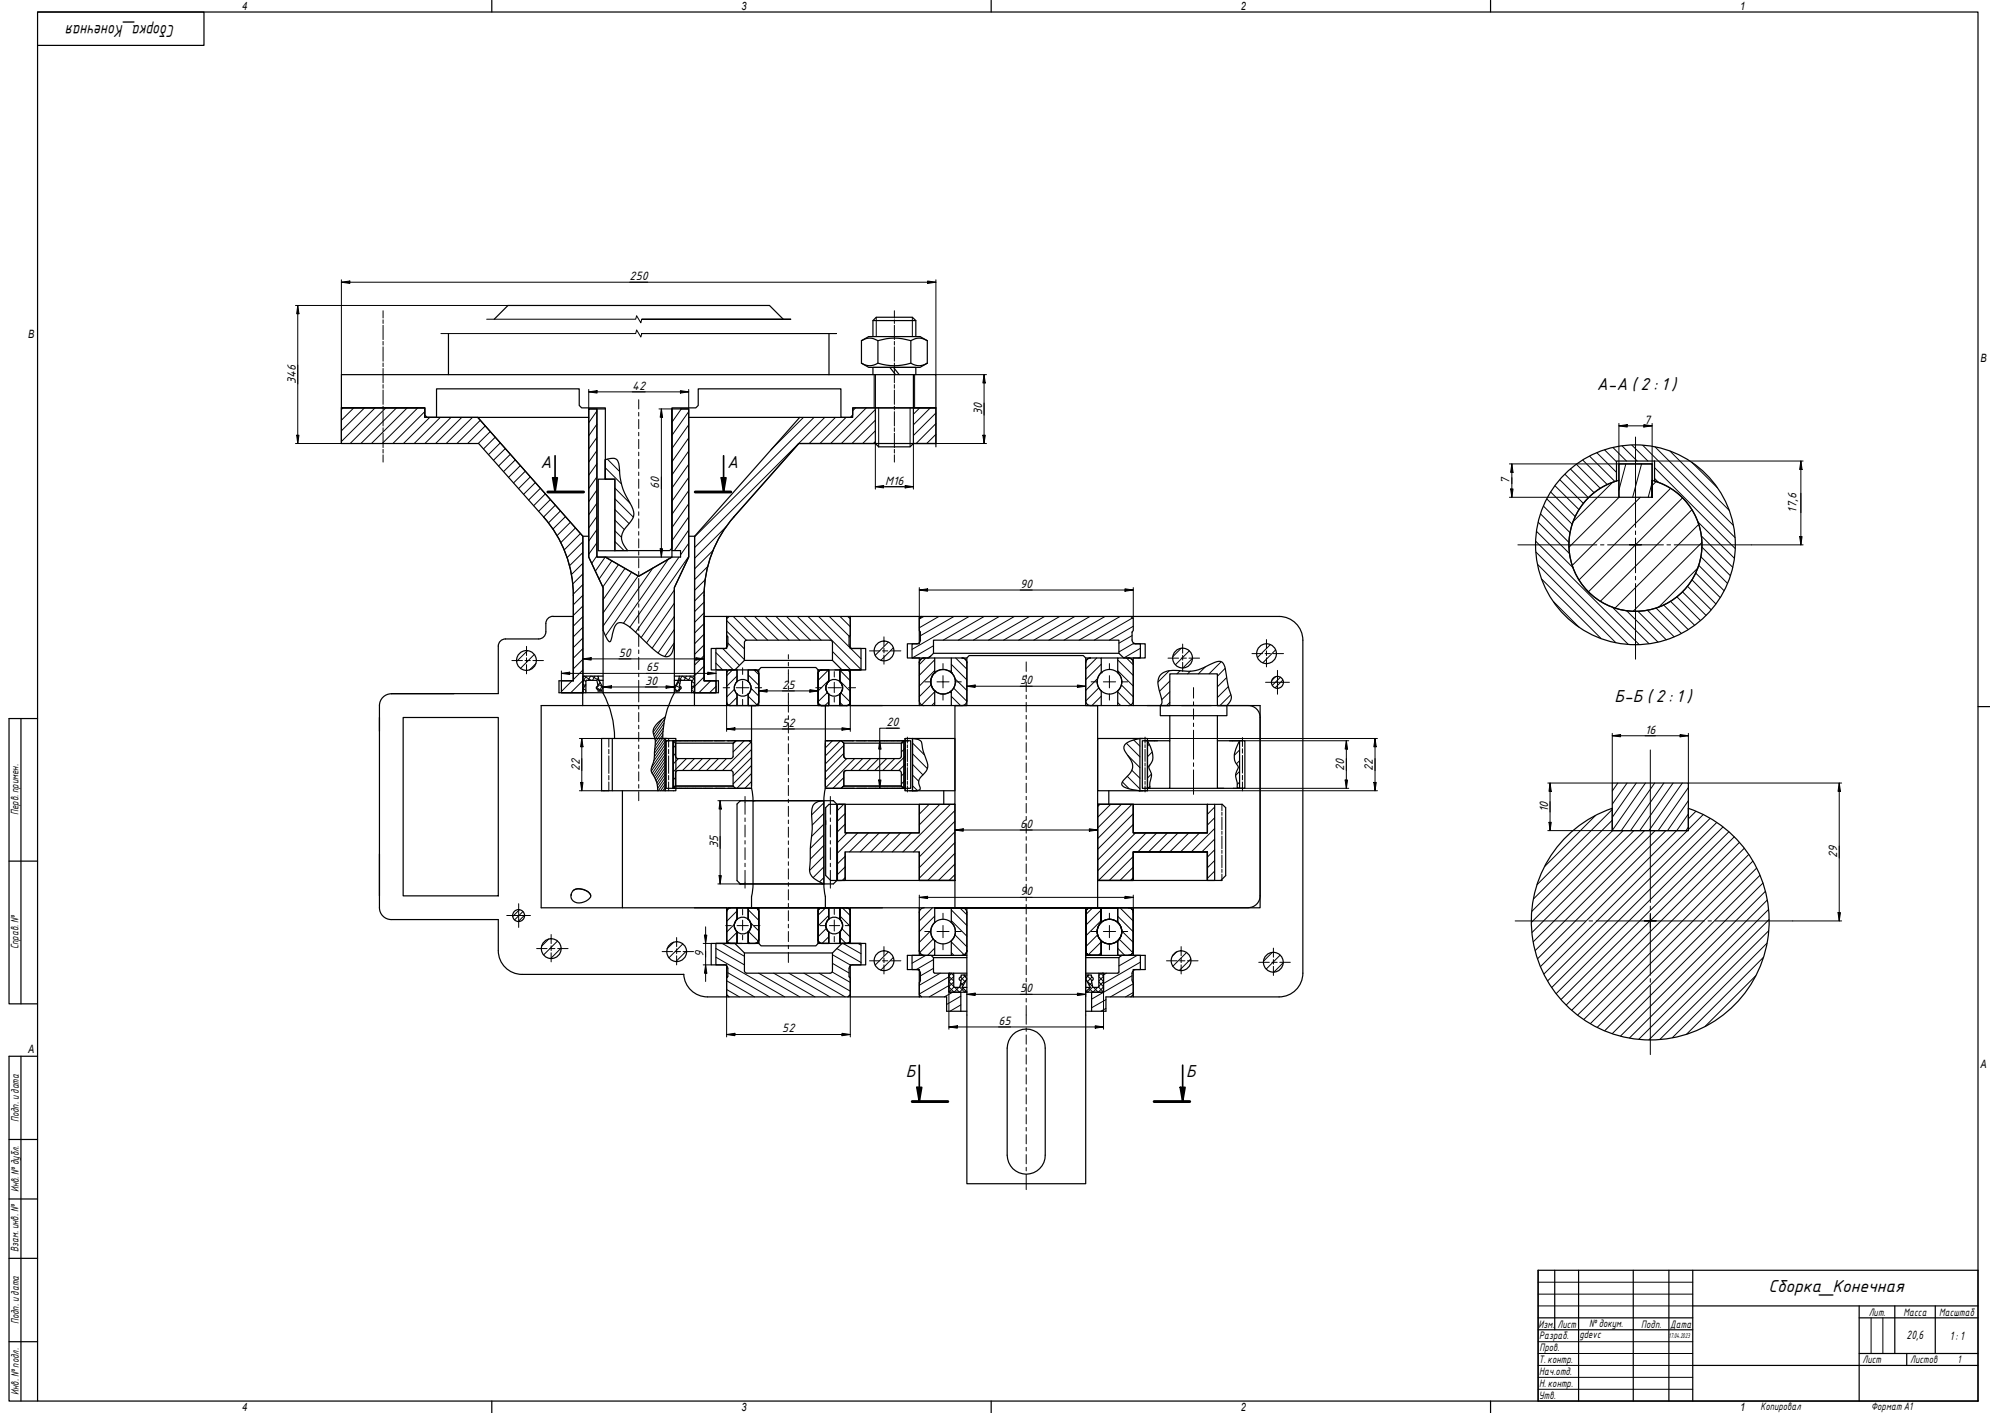
[picture p7: page 1]
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
