HerMak56/DetaliMashine/(commit log)

2023-04-20 Add shit
    [ANSI B 18.2.4.1 M - M10 x 1,5Style 1.ipt, Вал_тихоходный.0004.ipt, Вал_тихоходный.0005.ipt, Вал_тихоходный.ipt, Винт A.M10-6gx18 ГОСТ 17473-80.ipt, Втулка_Штрифта.0001.ipt, Втулка_Штрифта.ipt, Втулка_Штрифта_MIR.ipt]
2023-04-28 Add new hole in case
    [Валл_резина.0002.ipt, Валл_резина.ipt, Корпус.0037.ipt, Корпус.0039.ipt, Корпус.ipt, Корпус.v.2.0.0017.iam, Корпус.v.2.0.0019.iam, Корпус.v.2.0.iam]
2023-05-23 Last fixes
    [Лист_Муфт.0005.dwg, Лист_Муфт.0008.dwg, Лист_Муфт.0011.idw, Лист_Муфт.0013.idw, Лист_Муфт.dwg, Лист_Муфт.idw, Подшипник 1212 ГОСТ 28428-90.ipt, Сборка вала.0013.iam]
